kushpet/ebaz4205-sdr/hardware/Board files/README.md

# Installing Board Files

Download board files from this repository and copy ebaz4205 folder to your Xilinx Vivado installation directory "/<Vivado_version>/data/boards/board_files/".
