kushpet/ebaz4205-sdr/docs/EBAZ4205-ADC-DAC.md

| Разъём DATA1 | | | | | | | | | |
|---|---|---|-----|---|----|---|---|-----|---|
| | Верх | | | | | Низ | | | |
| | Разъем | Плата | Пин | Hw | | Разъем | Плата | Пин | Hw |
| 1 | VCC | +5V | | | 2  | VCC | +5V | | |
| 3 | Gnd | Gnd | | | 4  | Gnd | Gnd | | |
| 5 | DATA1-5  | CLK | A20 |CLK_DAC| 6  | DATA1-6  | BIT1  | H16 | DAC13 |
| 7 | DATA1-7  | BIT2  | B19 | DAC12 | 8  | DATA1-8  | BIT3  | B20 | DAC11 |
| 9 | DATA1-9  | BIT4  | C20 | DAC10 | 10 | | | | |
| 11 | DATA1-11 | BIT6  | H17 | DAC8  | 12 | gnd | | | |
| 13 | DATA1-13 | BIT8  | D20 | DAC6  | 14 | DATA1-14 | BIT5  | D18 | DAC9  |
| 15 | DATA1-15 | BIT10 | H18 | DAC4  | 16 | DATA1-16 | BIT7  | D19 | DAC7  |
| 17 | DATA1-17 | BIT12 | F20 | DAC2  | 18 | DATA1-18 | BIT9  | E19 | DAC5  |
| 19 | DATA1-19 | BIT13 | F19 | DAC1  | 20 | DATA1-20 | BIT11 | K17 | DAC3  |
| | | | | | | | | | |
| Разъём DATA2 | | | | | | | | | |
| | Верх | | | | | Низ | | | |
| | Разъем | Плата | Пин | Hw | | Разъем | Плата | Пин | Hw |
| 1 | VCC | +5V | | | 2  | VCC | +5V | | |
| 3 | Gnd | Gnd | | | 4  | Gnd | Gnd | | |
| 5 | DATA2-5  | BIT14 | G20 | DAC0  | 6  | DATA2-6  | PD | J18 | PD |
| 7 | DATA2-7  | | G19 | | 8  | DATA2-8  | | H20 | |
| 9 | DATA2-9  | | J19 | | 10 | | | | |
| 11 | DATA2-11 | | K18 | | 12 | gnd | | | |
| 13 | DATA2-13 | | K19 | | 14 | DATA2-14 | | J20 | |
| 15 | DATA2-15 | | L16 | | 16 | DATA2-16 | | L19 | |
| 17 | DATA2-17 | | M18 | | 18 | DATA2-18 | | L20 | |
| 19 | DATA2-19 | | M20 | | 20 | DATA2-20 | | L17 | |
| | | | | | | | | | |
| Разъём DATA3 | | | | | | | | | |
| | Верх | | | | | Низ | | | |
| | Разъем | Плата | Пин | Hw | | Разъем | Плата | Пин | Hw |
| 1 | VCC | +5V | | | 2  | VCC | +5V | | |
| 3 | Gnd | Gnd | | | 4  | Gnd | Gnd | | |
| 5 | DATA3-5  | CLK | M19 |CLK_ADC| 6  | DATA3-6  | BIT12 | N20 | ADC0  |
| 7 | DATA3-7  | BIT11 | P18 | ADC1  | 8  | DATA3-8  | BIT10 | M17 | ADC2  |
| 9 | DATA3-9  | BIT9  | N17 | ADC3  | 10 | | | | |
| 11 | DATA3-11 | BIT7  | P20 | ADC5  | 12 | gnd | | | |
| 13 | DATA3-13 | BIT5  | R18 | ADC7  | 14 | DATA3-14 | BIT8  | R19 | ADC4  |
| 15 | DATA3-15 | BIT3  | P19 | ADC9  | 16 | DATA3-16 | BIT6  | T20 | ADC6  |
| 17 | DATA3-17 | BIT1  | U20 | ADC11 | 18 | DATA3-18 | BIT4  | T19 | ADC8  |
| 19 | DATA3-19 | OTR | V20 | OTR | 20 | DATA3-20 | BIT2  | U19 | ADC10 |
