kushpet/ebaz4205-sdr/docs/ebaz4205_schematic_color.pdf

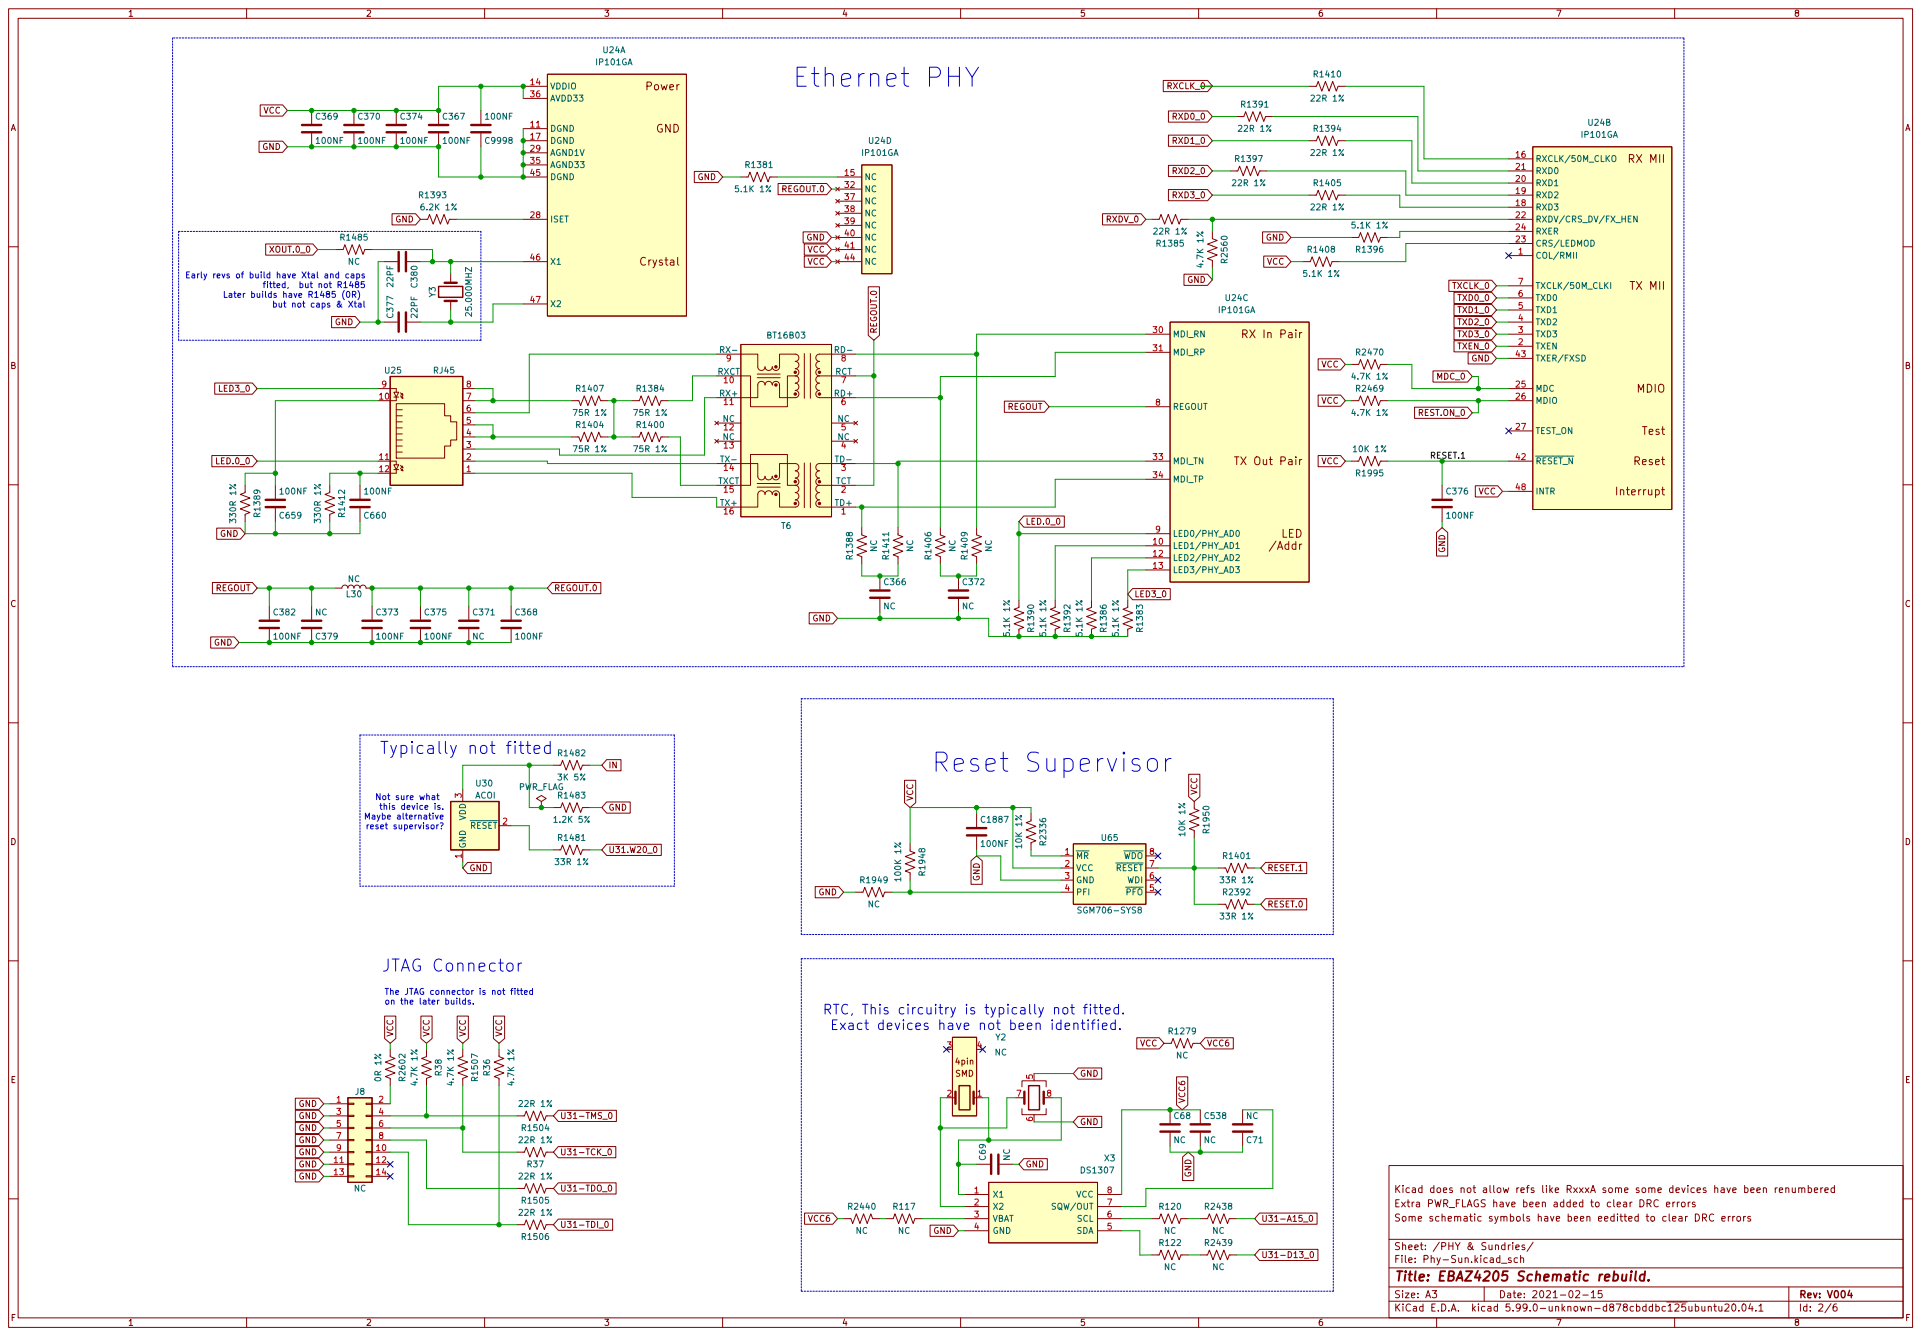
[picture p2: page 1]

RESET.1 Early revs of build have Xtal and caps

but not caps & Xtal

JTAG Connector Not sure what
this device is. Maybe alternative

reset supervisor? The JTAG connector is not fitted

RTC, This circuitry is typically not fitted.
Exact devices have not been identified.

File: Phy-Sun.kicad_sch Sheet: /PHY & Sundries/ Some schematic symbols have been eeditted to clear DRC errors

Id: 2/6 Title: EBAZ4205 Schematic rebuild.

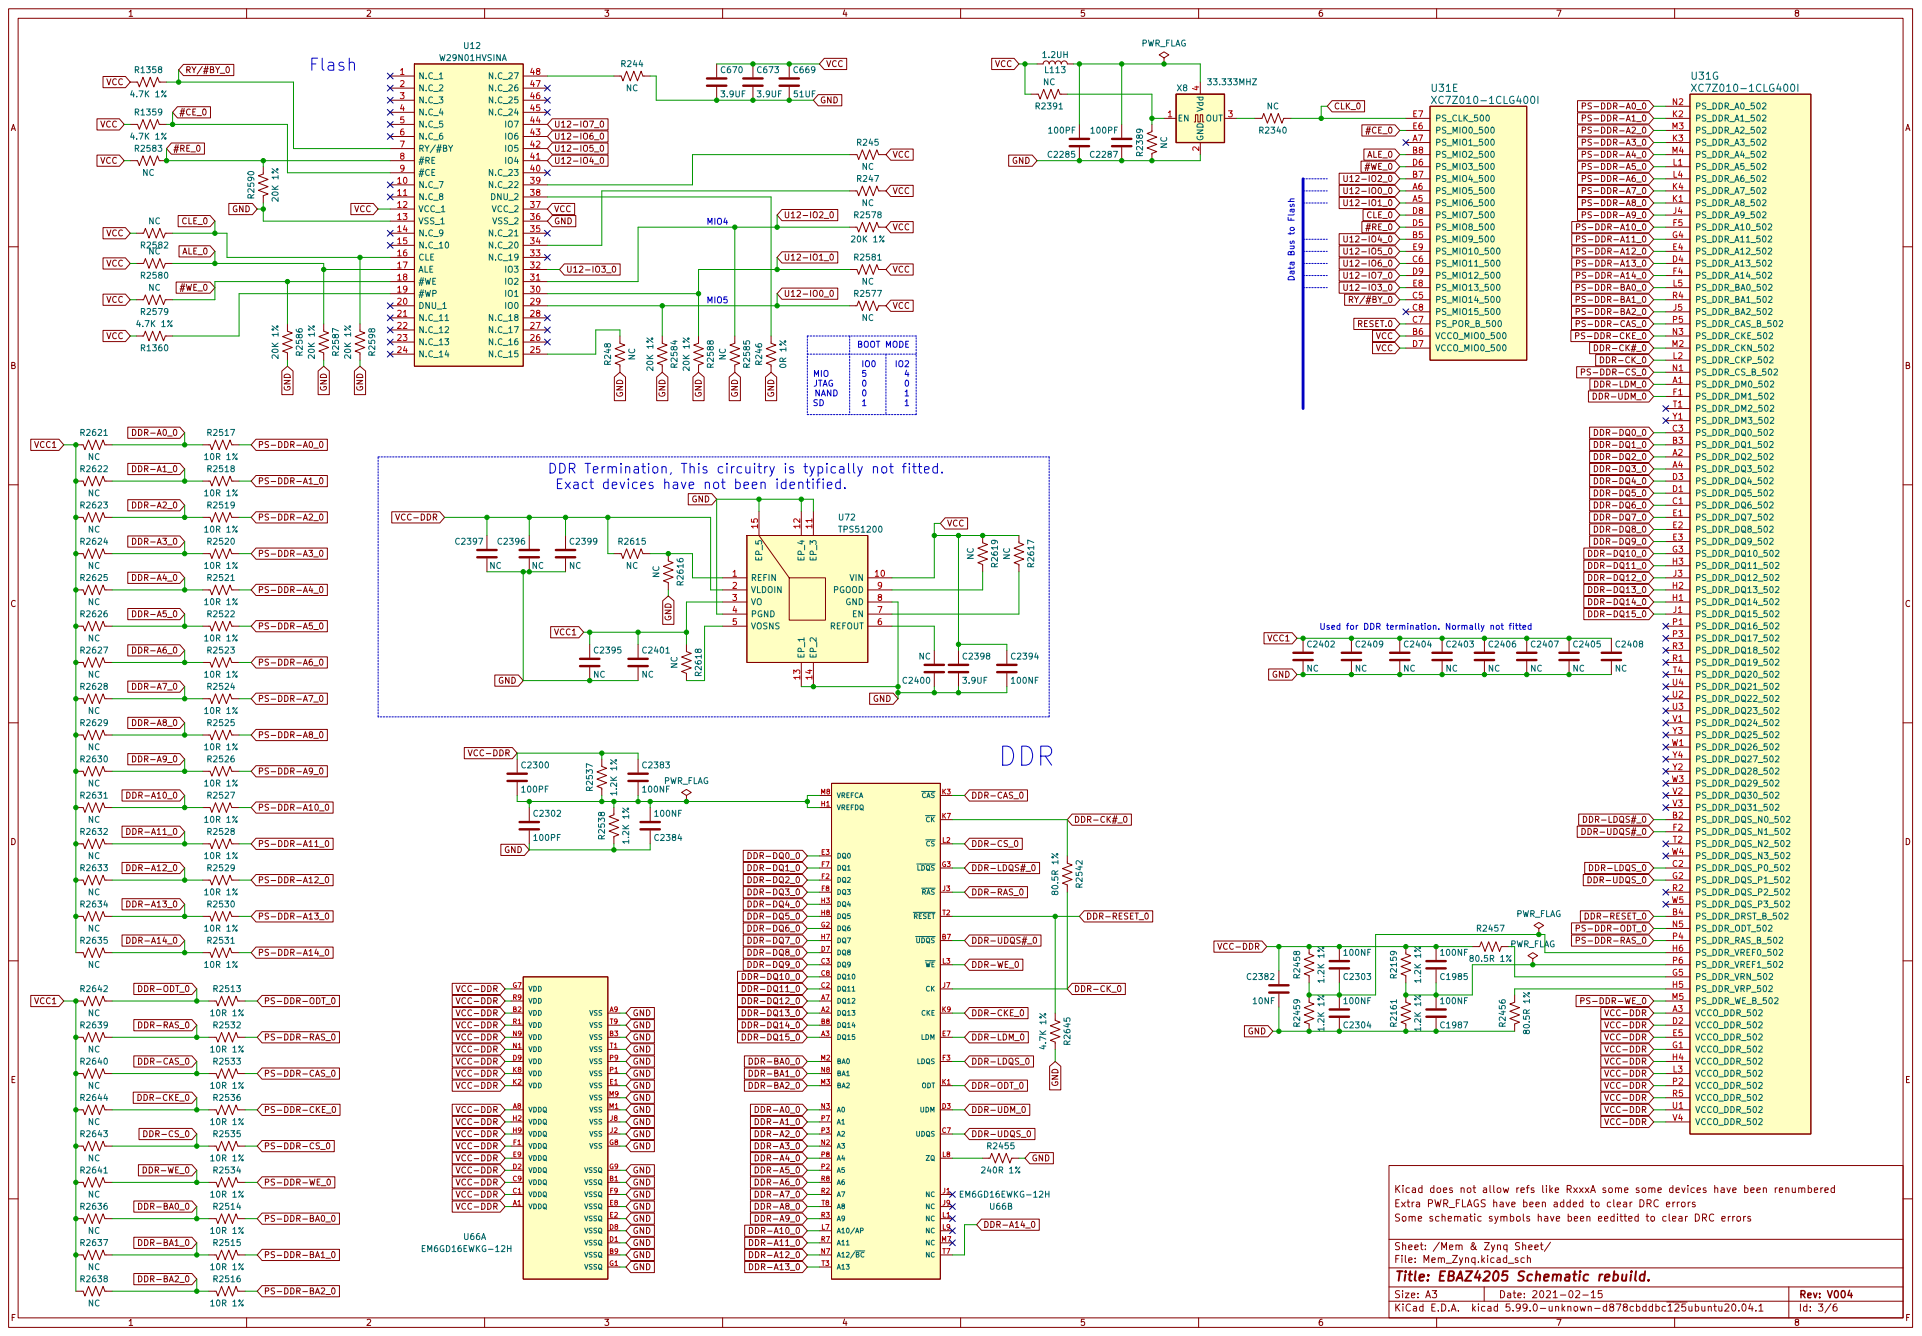
[picture p3: page 2]

XC7Z010-1CLG400I R2522
PS-DDR-A13_0 PS-DDR-A14_0 PS-DDR-BA0_0 PS-DDR-BA1_0 PS-DDR-A7_0 VCC

PS-DDR-A2_0 PS-DDR-A12_0 PS-DDR-A4_0 U12-IO1_0 U12-IO0_0 U12-IO2_0

MIO5 DDR Termination, This circuitry is typically not fitted.

PS-DDR-BA2_0 PS-DDR-CAS_0 PS-DDR-CKE_0 DDR-CK#_0 DDR-CK_0 PS-DDR-CS_0 DDR-LDM_0 DDR-UDM_0
DDR-DQ8_0 DDR-DQ9_0 DDR-LDQS#_0 DDR-UDQS#_0 DDR-LDQS_0 DDR-UDQS_0 DDR-RESET_0 PS-DDR-ODT_0 PS-DDR-RAS_0 PS-DDR-WE_0

DDR-DQ7_0 DDR-DQ3_0 DDR-DQ6_0 DDR-DQ5_0 DDR-DQ4_0

Exact devices have not been identified.

VCC1 GND
DDR-RESET_0 DDR-CK#_0 GND

VCC-DDR
DDR-BA0_0 DDR-A12_0 DDR-A11_0 DDR-A10_0 DDR-A9_0 DDR-A8_0 DDR-A7_0 DDR-A6_0 DDR-A5_0 DDR-A4_0 DDR-A3_0 DDR-A2_0 DDR-A1_0 DDR-A0_0 DDR-BA2_0 DDR-BA1_0 VCC-DDR

VCC-DDR GND GND GND GND

Extra PWR_FLAGS have been added to clear DRC errors Kicad does not allow refs like RxxxA some some devices have been renumbered R2515

Some schematic symbols have been eeditted to clear DRC errors

Sheet: /Mem & Zynq Sheet/
File: Mem_Zynq.kicad_sch
Id: 3/6 Title: EBAZ4205 Schematic rebuild.

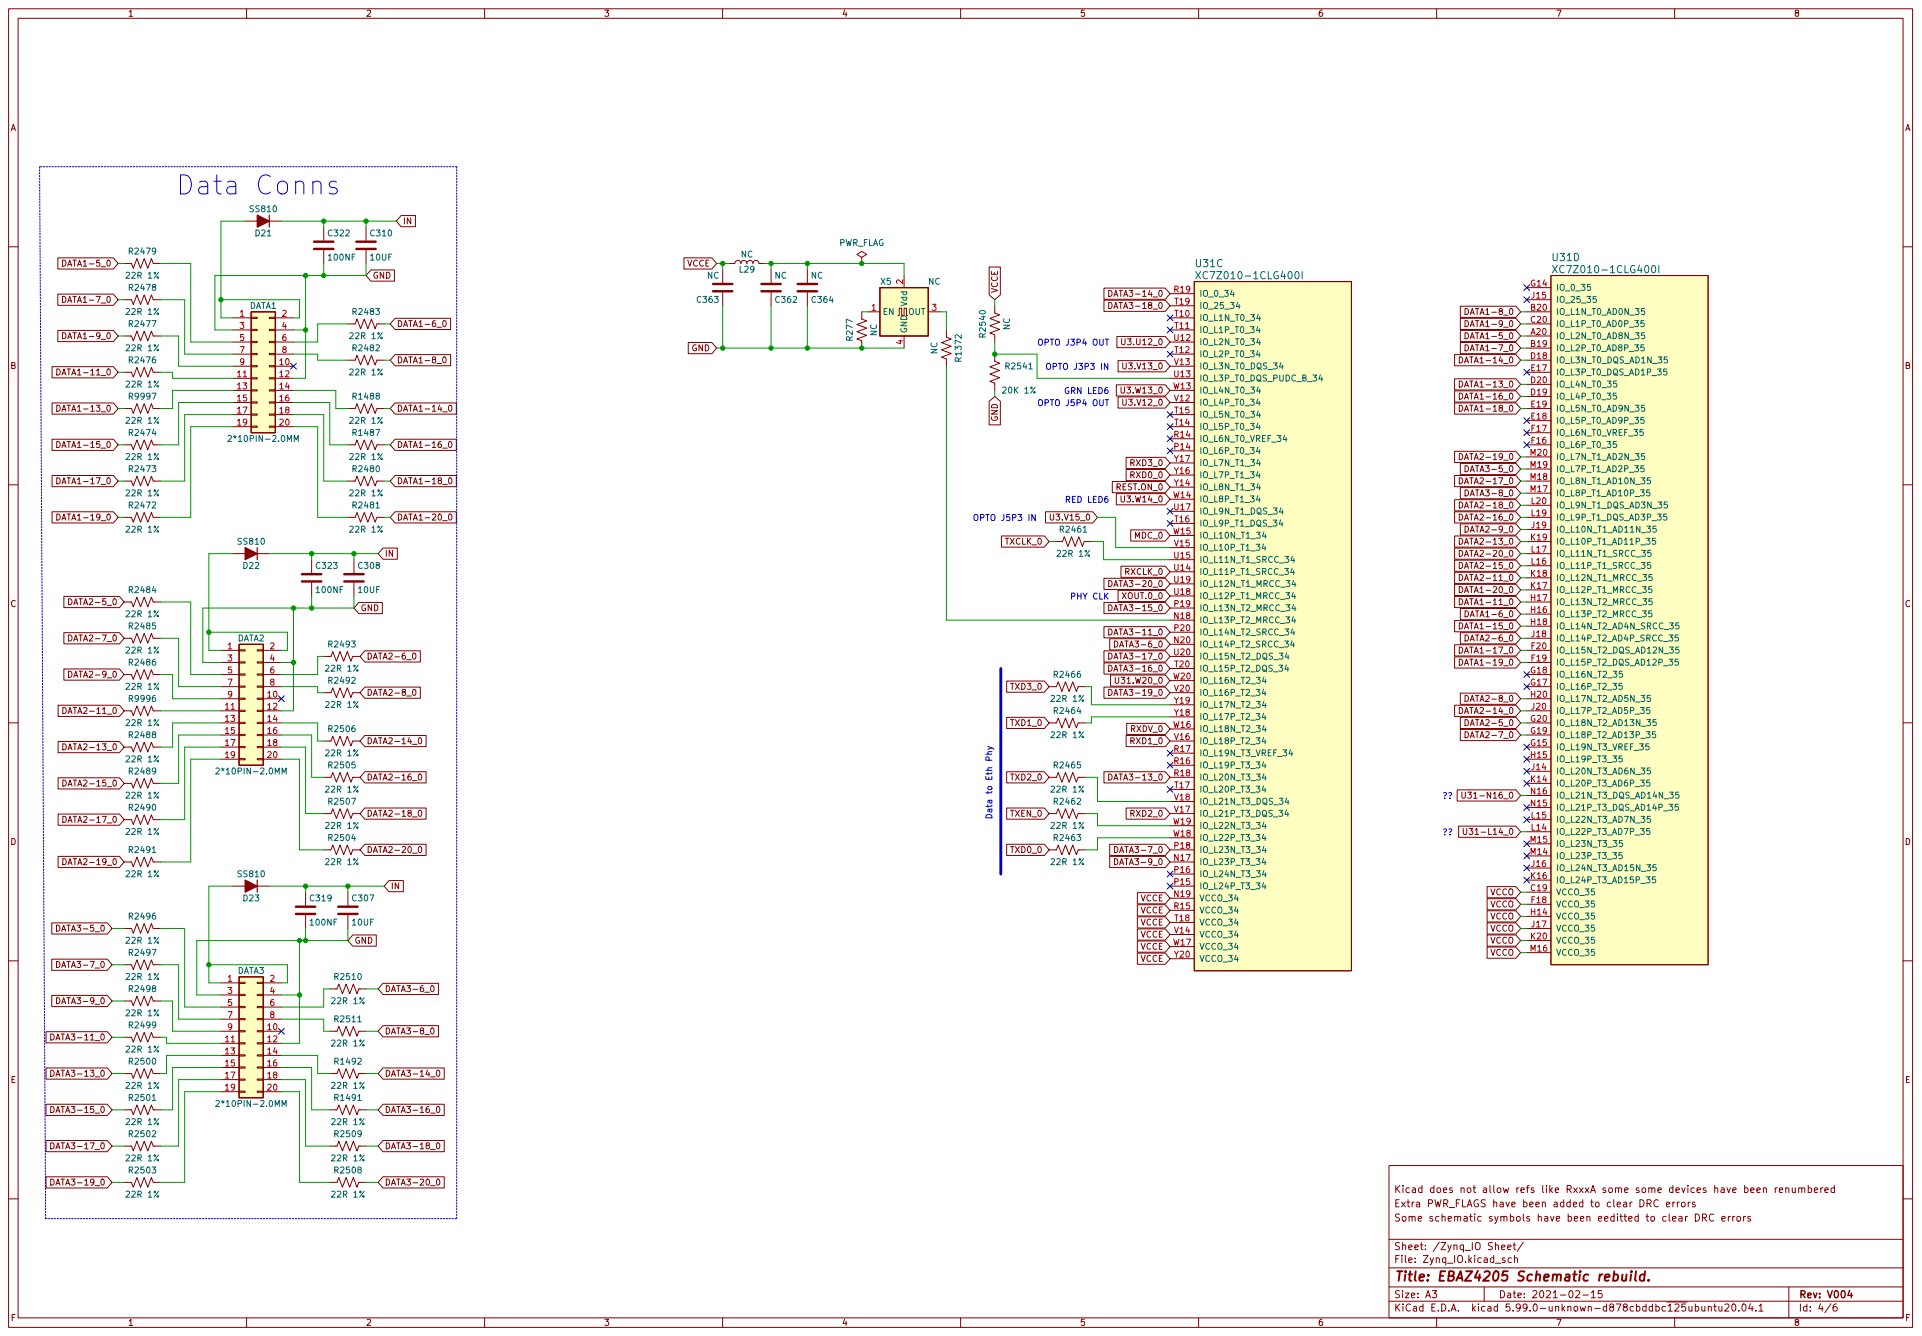
[picture p4: page 3]
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

Some schematic symbols have been eeditted to clear DRC errors

Sheet: /Zynq_IO Sheet/
File: Zynq_IO.kicad_sch
Id: 4/6 Title: EBAZ4205 Schematic rebuild.

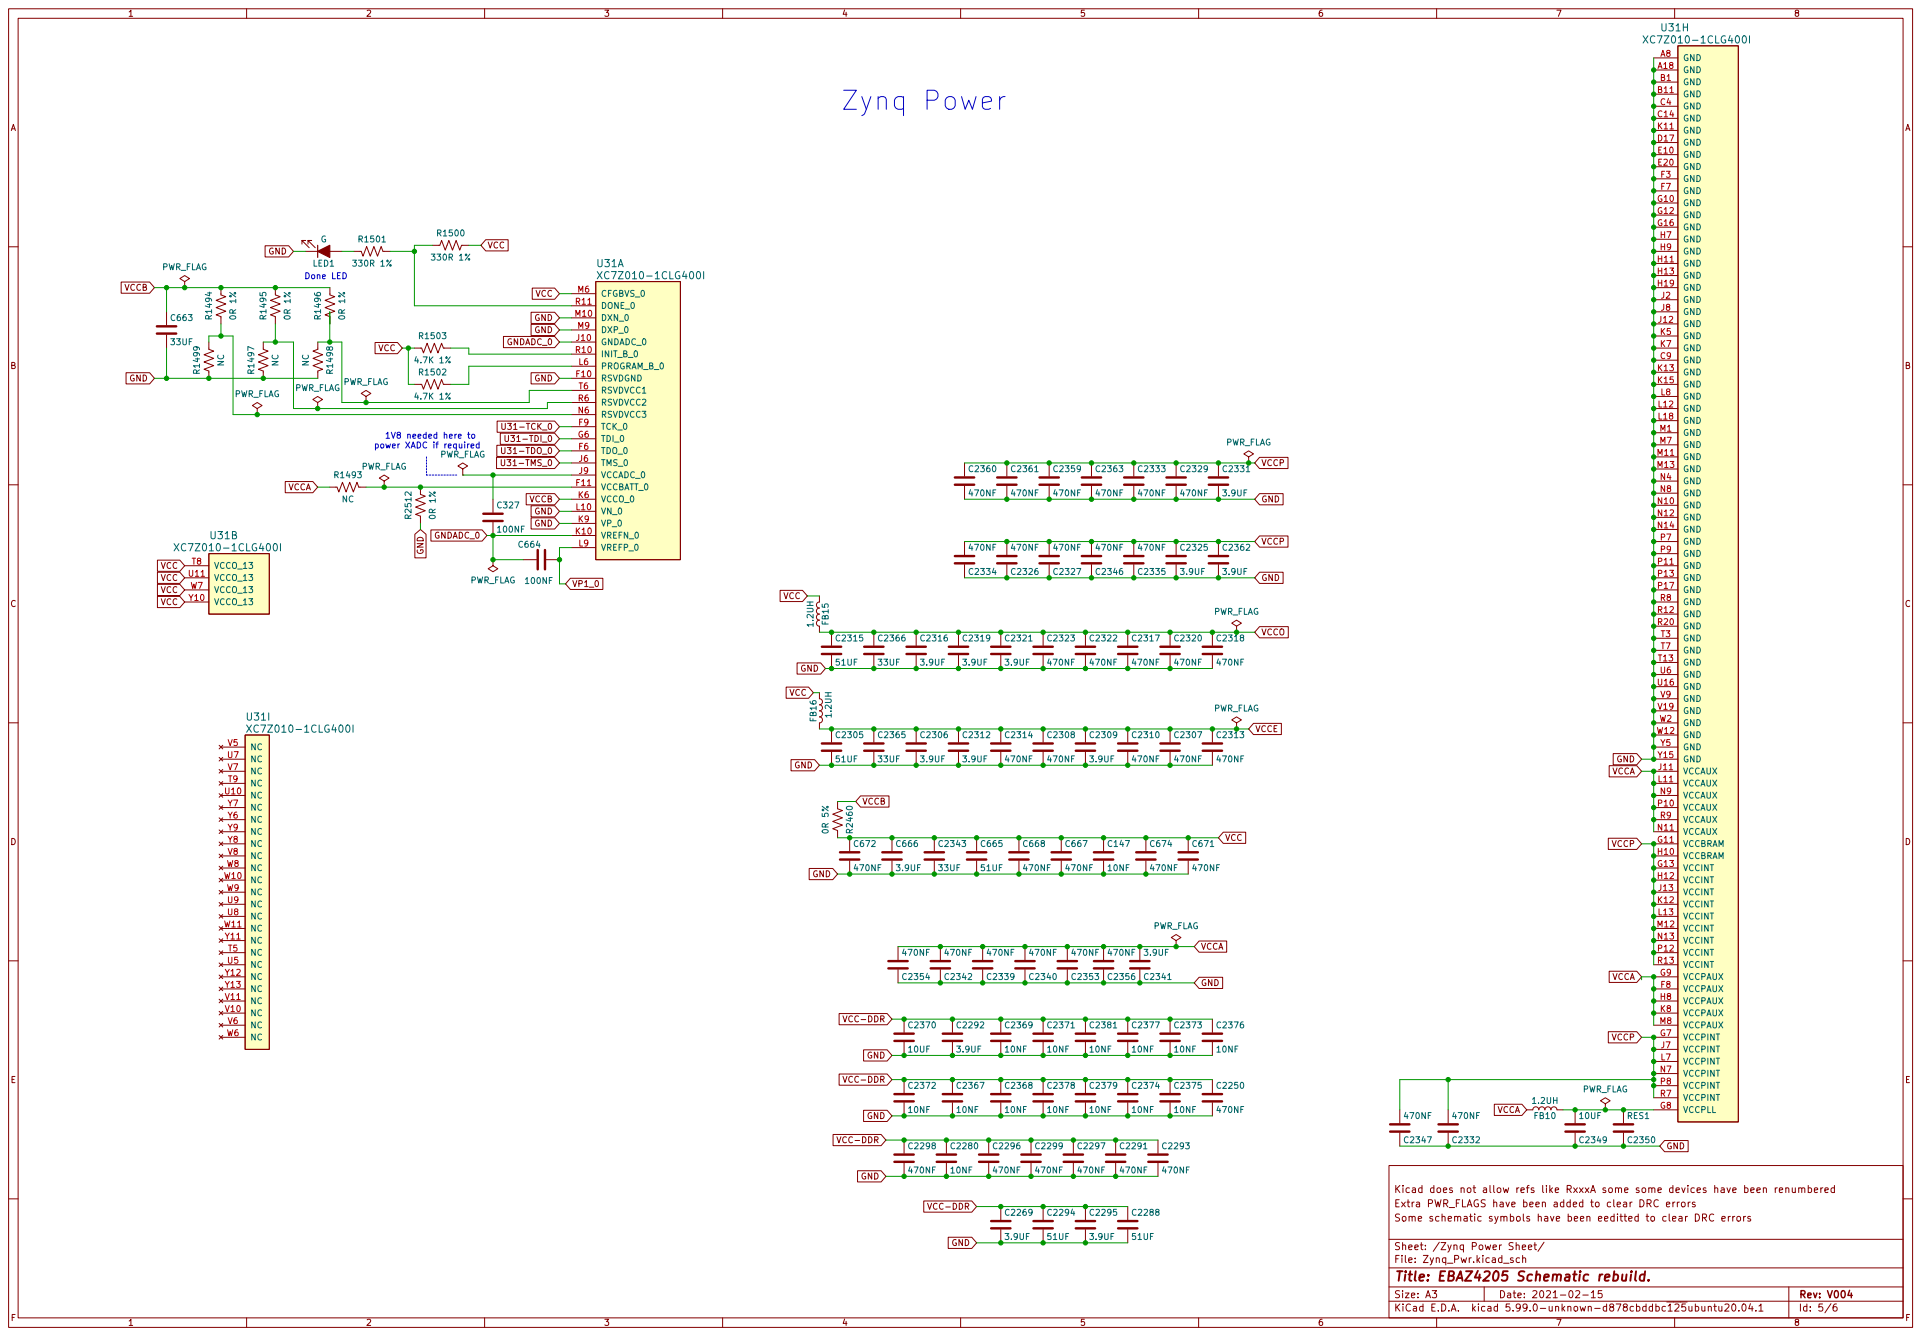
[picture p5: page 4]

1V8 needed here to power XADC if required

Extra PWR_FLAGS have been added to clear DRC errors Kicad does not allow refs like RxxxA some some devices have been renumbered C2373

Some schematic symbols have been eeditted to clear DRC errors

Sheet: /Zynq Power Sheet/
File: Zynq_Pwr.kicad_sch
Id: 5/6 Title: EBAZ4205 Schematic rebuild.

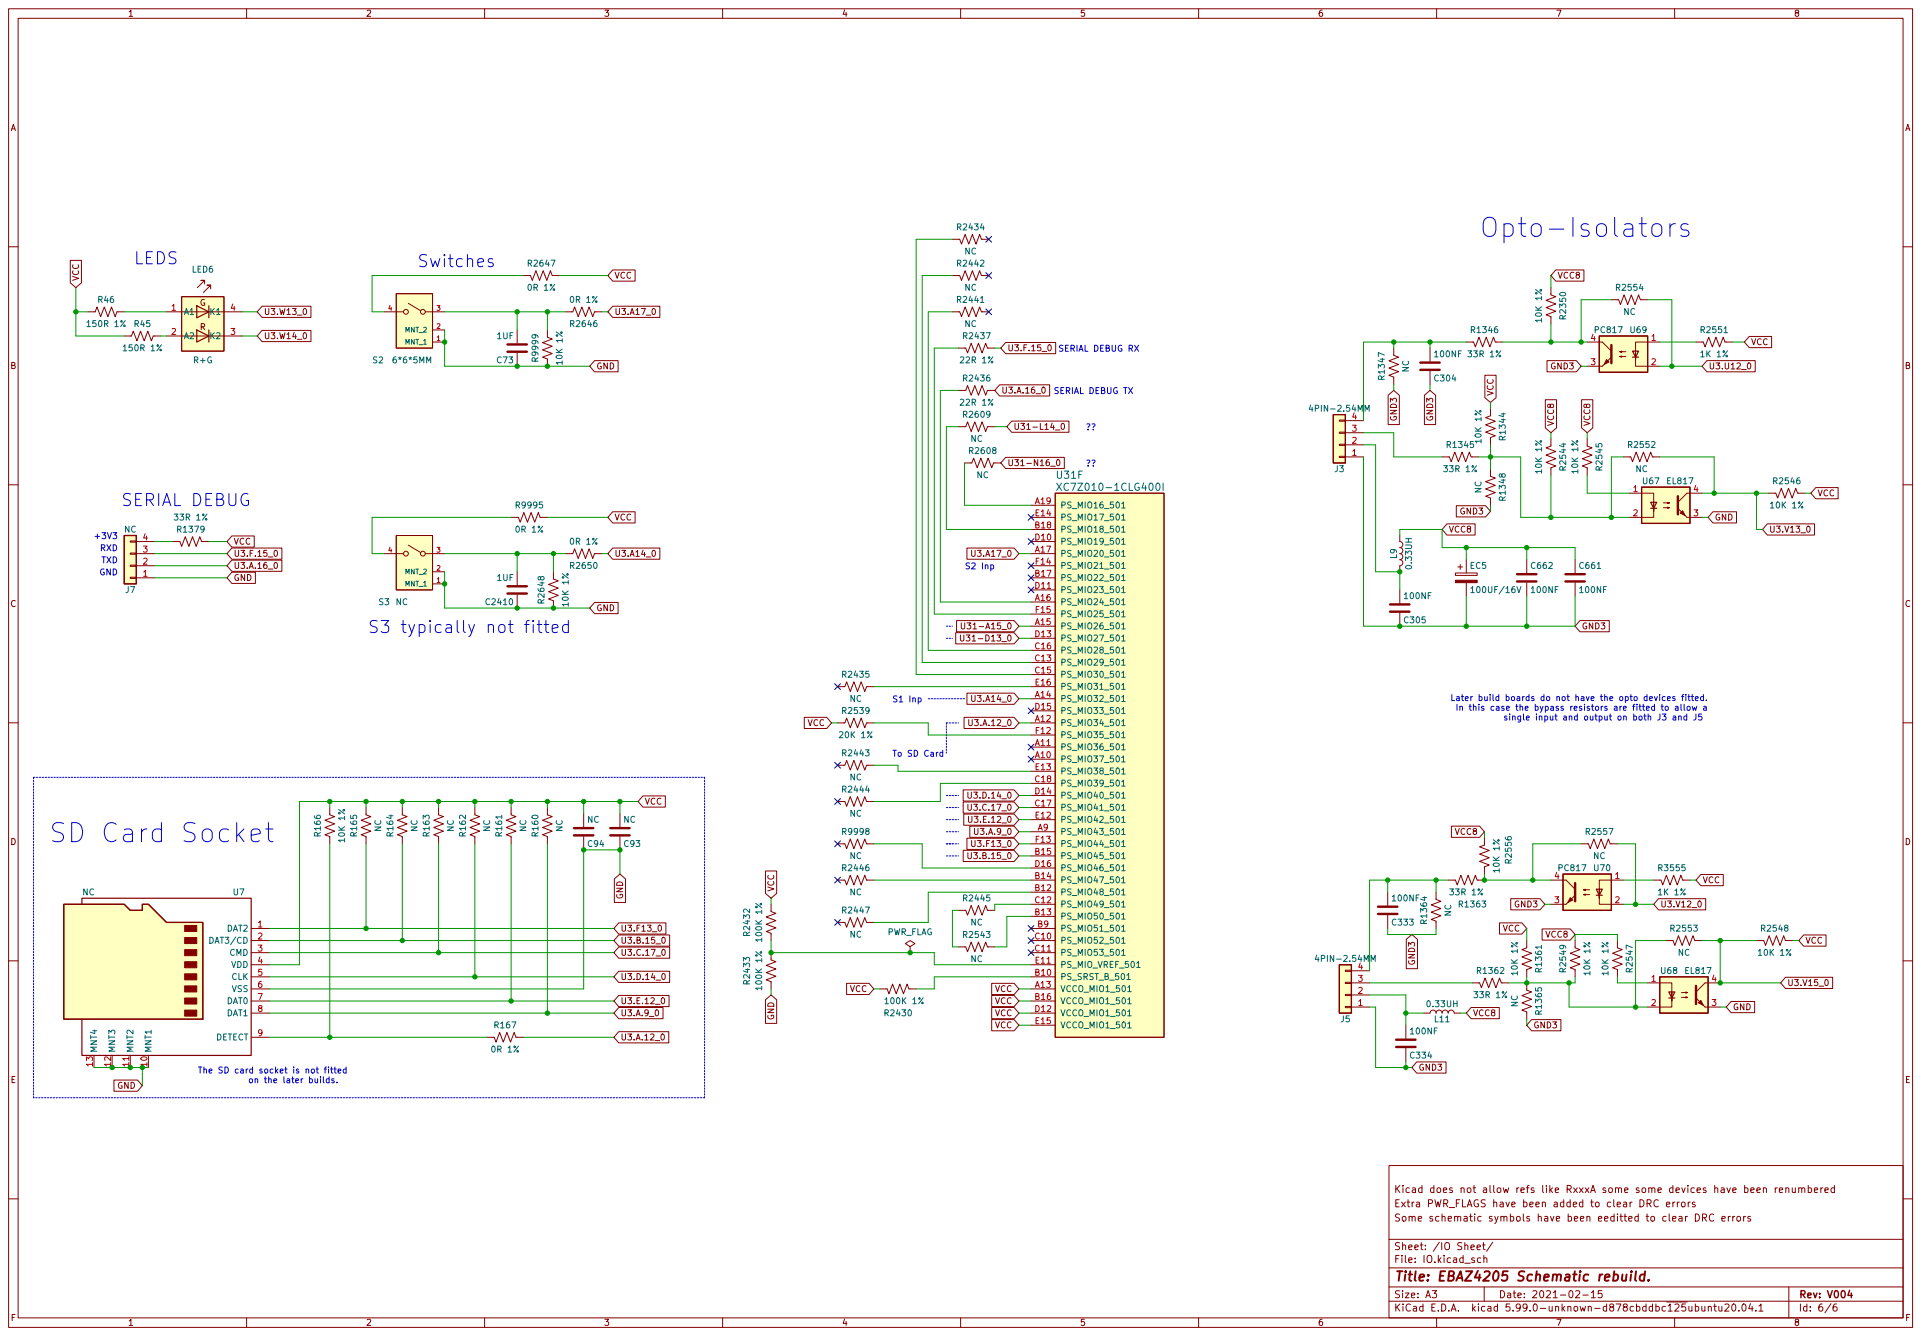
[picture p6: page 5]

single input and output on both J3 and J5 ?? SERIAL DEBUG RX

S2 Inp To SD Card

Later build boards do not have the opto devices fitted.
In this case the bypass resistors are fitted to allow a

on the later builds.

File: IO.kicad_sch Sheet: /IO Sheet/ Some schematic symbols have been eeditted to clear DRC errors

Id: 6/6 Title: EBAZ4205 Schematic rebuild.

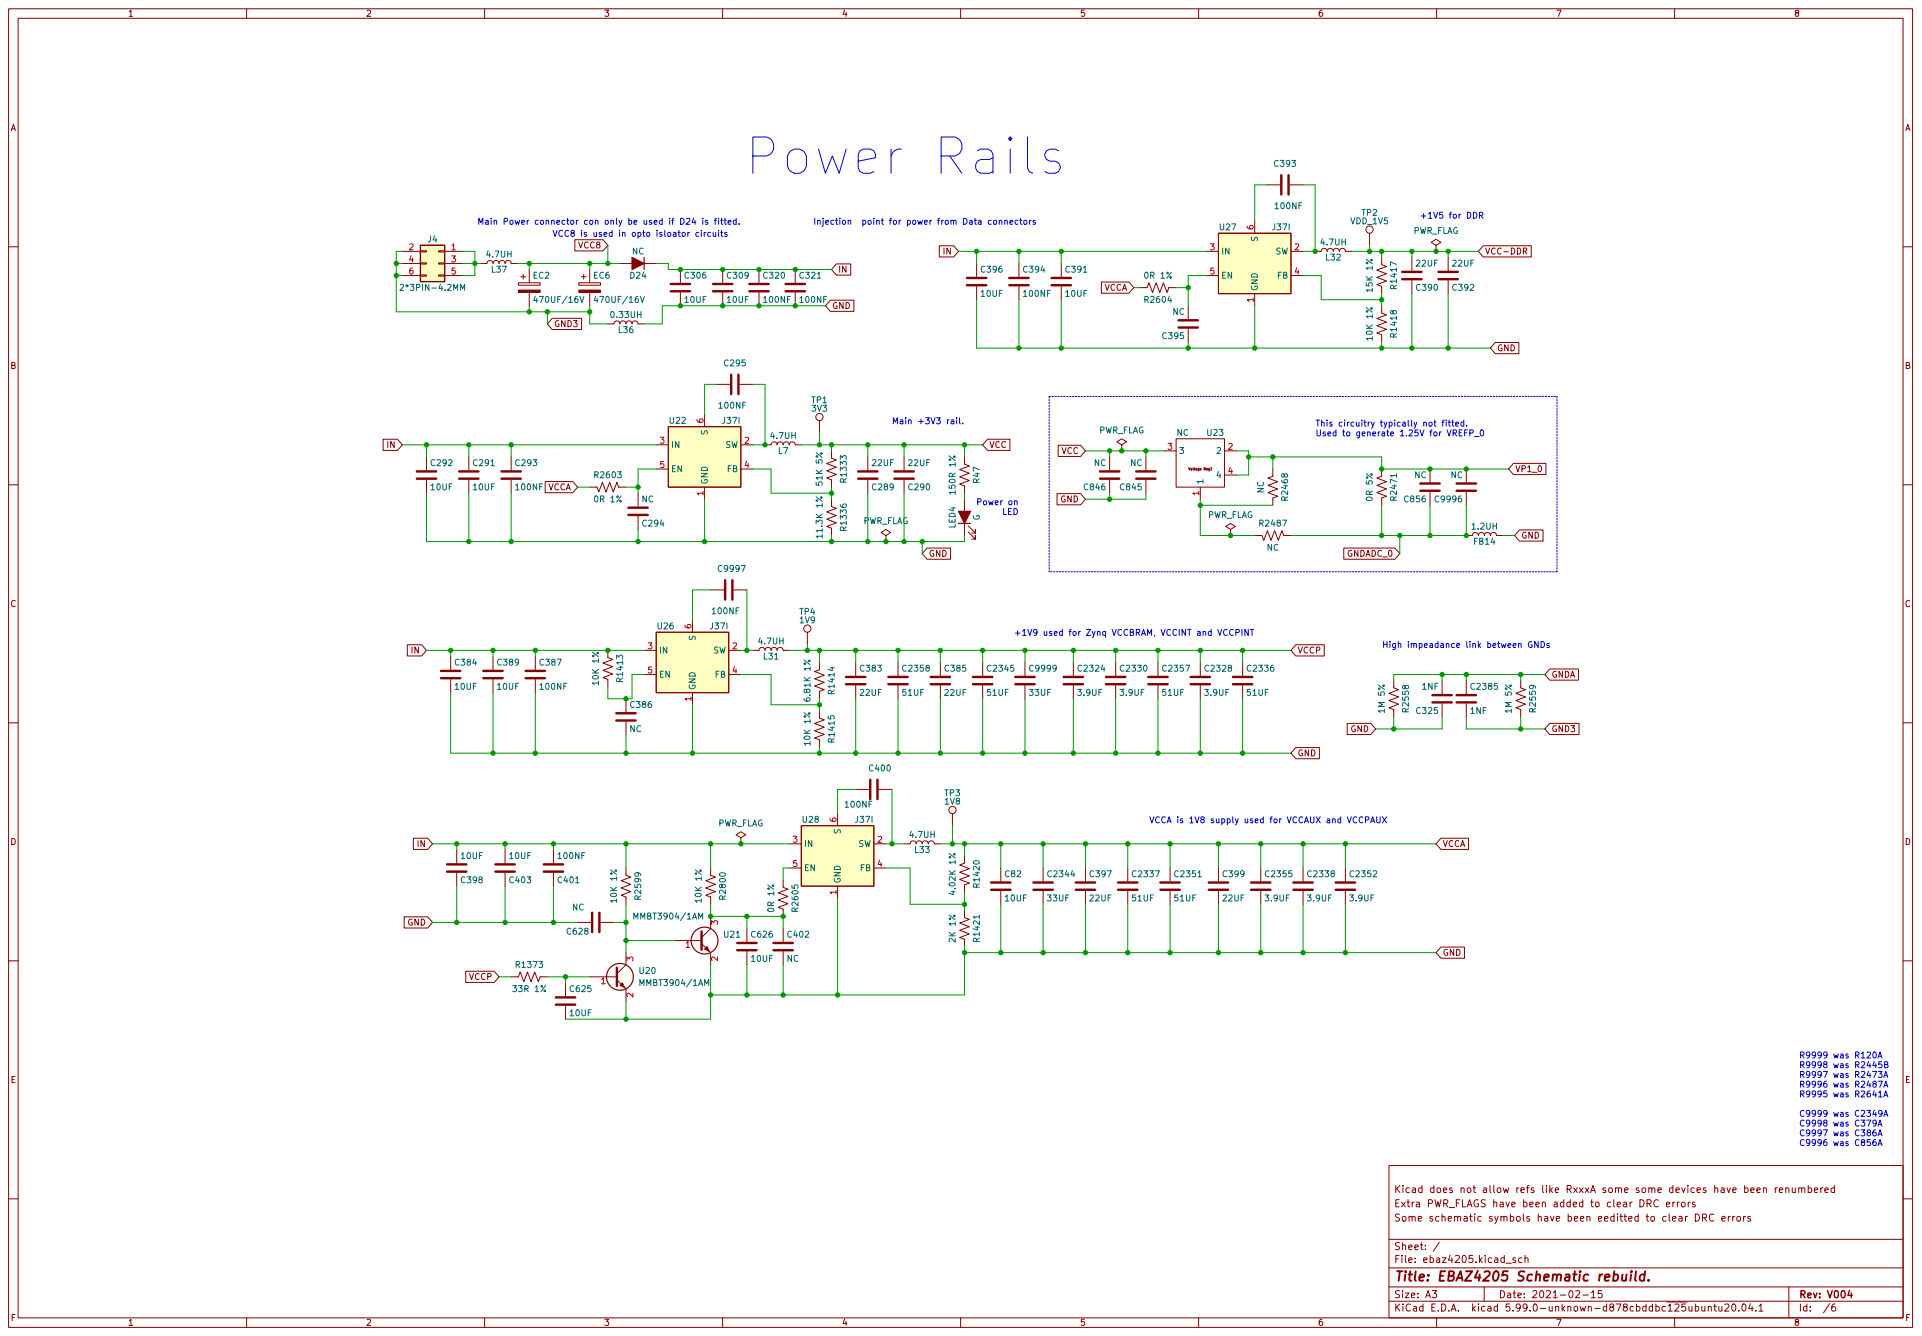
[picture p7: page 6]

Injection point for power from Data connectors

This circuitry typically not fitted.
Used to generate 1.25V for VREFP_0

High impeadance link between GNDs

VCCA is 1V8 supply used for VCCAUX and VCCPAUX

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

File: ebaz4205.kicad_sch Sheet: / Some schematic symbols have been eeditted to clear DRC errors

Id: /6 Title: EBAZ4205 Schematic rebuild.
