kushpet/ebaz4205-sdr/docs/AD9226-V1.2-board.pdf

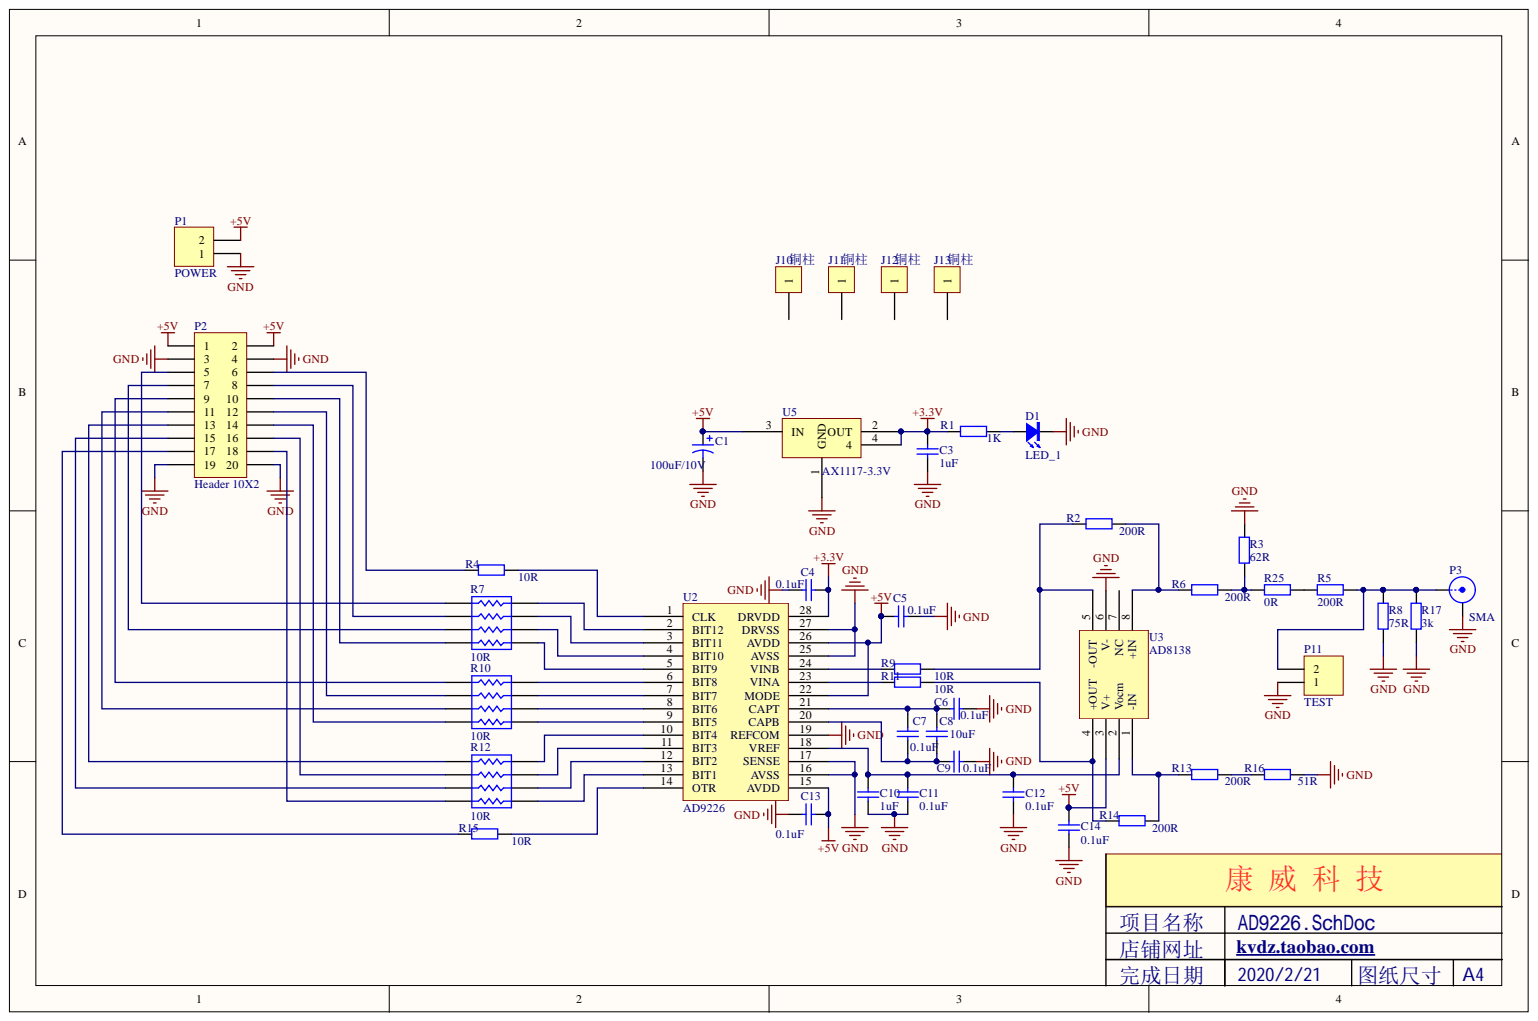
[picture p8: page 1]

P2Header 1 7 8

9 1 0
1 1 1 2
1 3 1 4
1 5 1 6
1 7 1 8

-IN 1 Vocm 2 V+ 3 +OUT 4 -OUT 5 V- 6 NC 7 +IN 8

1 1 | | | F
1 2
1 3 | 1 | C9 | 0.1 u F
1 4 | 1 5 | C1 | | V
