kushpet/ebaz4205-sdr/docs/DAC904-board.pdf

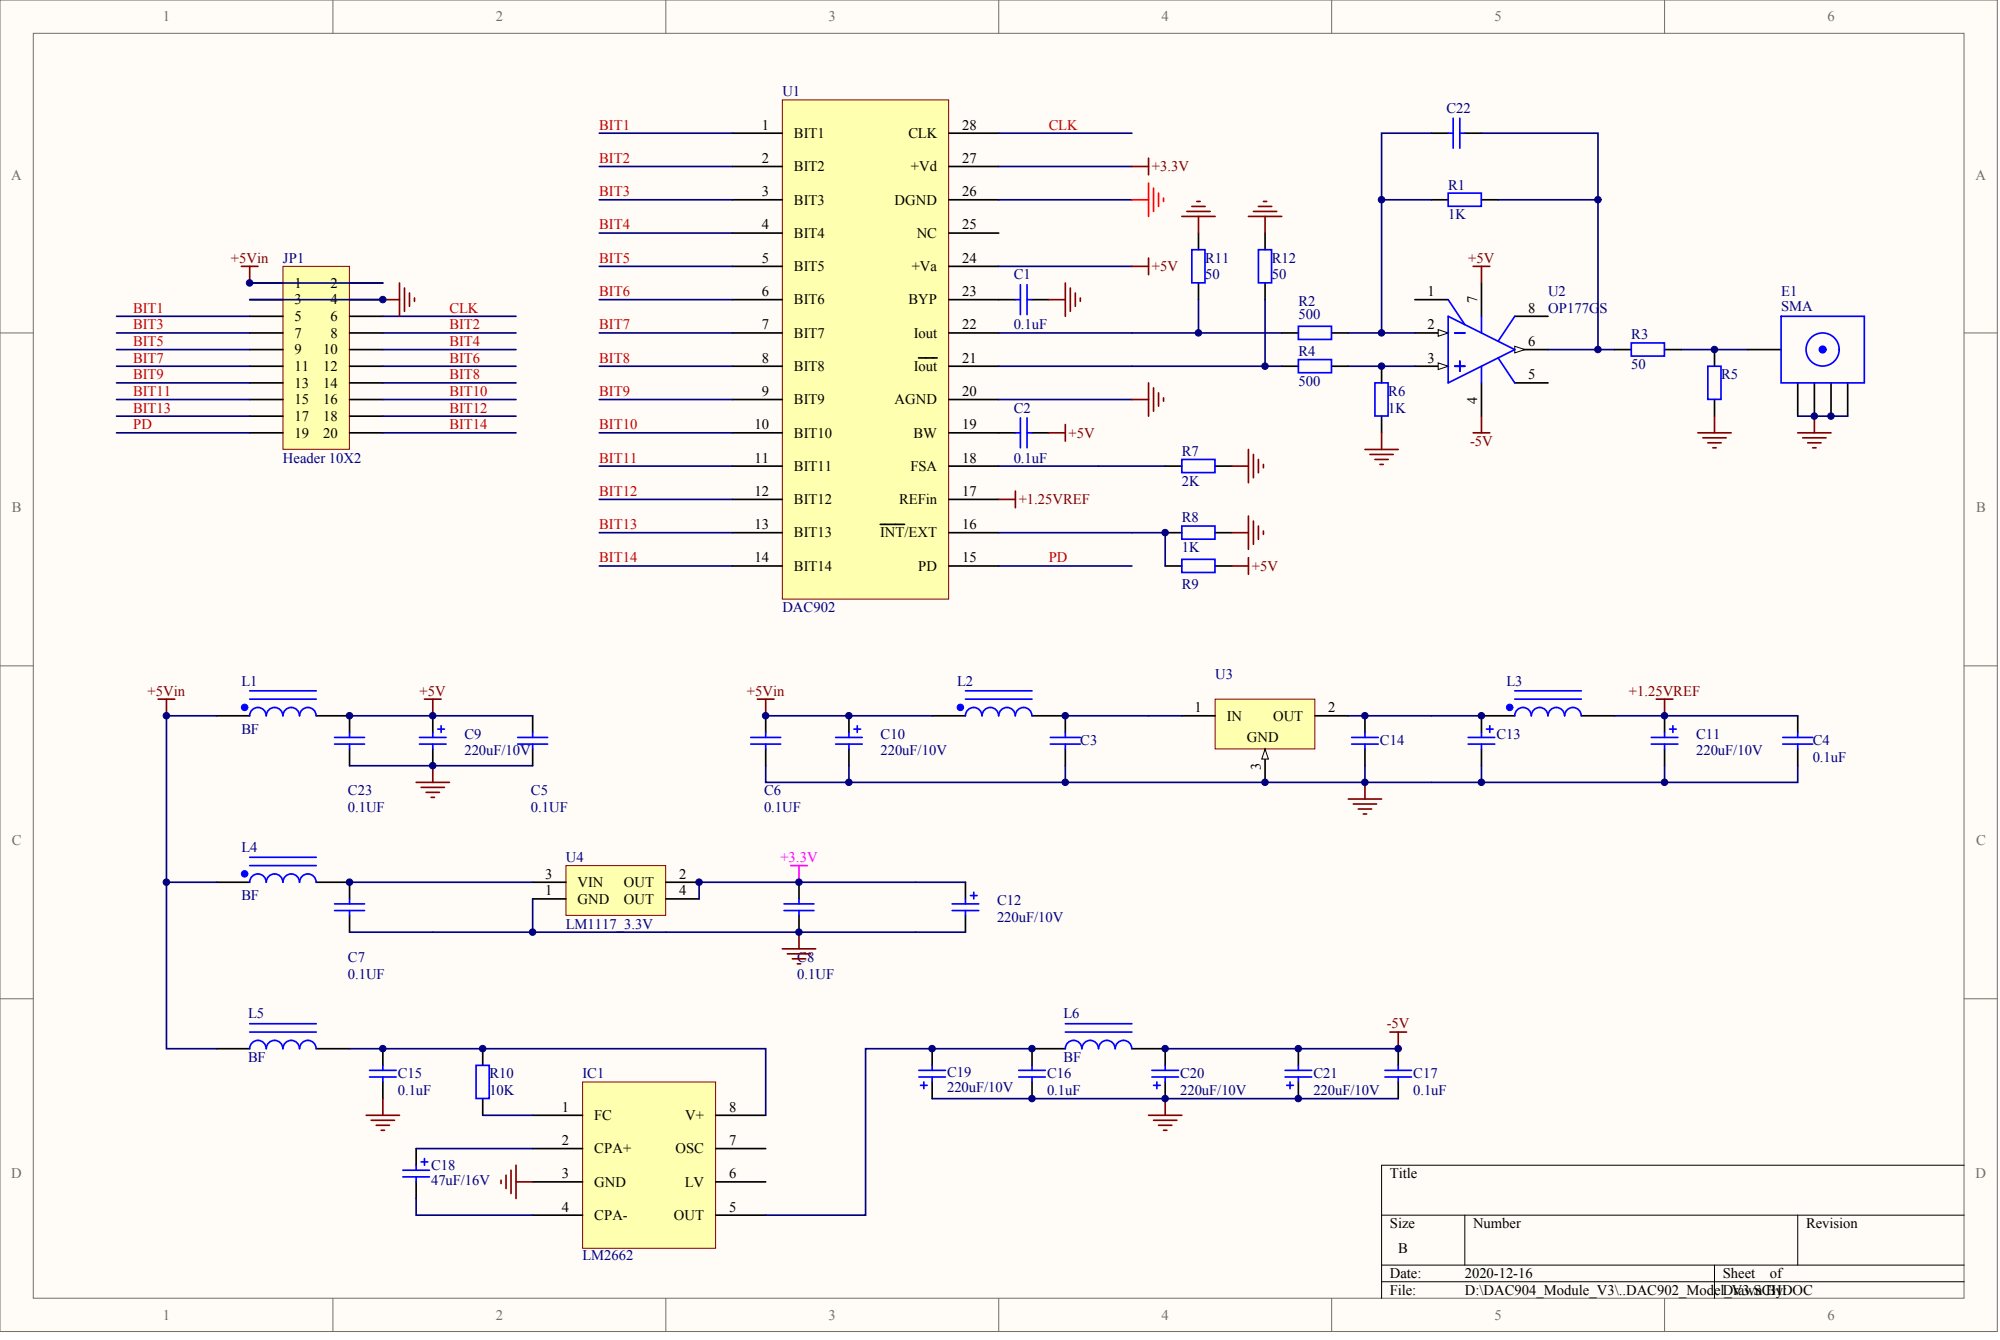
[picture p9: page 1]

CPA+ 2 OSC P0IC107 P0IC107 P0IC107 LV | 7

GND 3 | 6 P0IC106 P0IC106 P0IC106
