kushpet/ebaz4205-sdr/hardware/rtl/hb_fir_decimator.v

// hardware/rtl/hb_fir_decimator.v
// Halfband FIR decimator x2, 63-tap (32 non-zero), transposed form
// CIC-compensating coefficients (R_max=120, N=5, Parks-McClellan)
// Input: 16-bit signed @ fs_cic  Output: 16-bit signed @ fs_cic/2
// Single channel — instantiate for I and Q separately
// DSP48: 16 (symmetric pairs, center = >>1 shift, no DSP)
//
// Coefficient set (h[0],h[2],...,h[30]): 18-bit Q16
//   h[31]=65536 (center, 0.5 in Q16, done as arithmetic right shift)
//   h[i] = h[62-i] (linear phase symmetry)

module hb_fir_decimator #(
    parameter B_IN  = 16,
    parameter B_OUT = 16,
    parameter B_ACC = 42,   // B_IN+1 + 18 + log2(16) = 39 -> 42 safe
    parameter AXI_ADDR_WIDTH = 6
)(
    input  wire               clk,
    input  wire               resetn,
    input  wire [B_IN-1:0]    din,
    input  wire               din_valid,
    output reg  [B_OUT-1:0]   dout,
    output reg                dout_valid,
    // AXI-Lite: optional coefficient reload (offsets 0x00..0x3C = 16 regs)
    input  wire [AXI_ADDR_WIDTH-1:0] s_axil_awaddr,
    input  wire               s_axil_awvalid,
    output reg                s_axil_awready,
    input  wire [31:0]        s_axil_wdata,
    input  wire               s_axil_wvalid,
    output reg                s_axil_wready,
    output reg  [1:0]         s_axil_bresp,
    output reg                s_axil_bvalid,
    input  wire               s_axil_bready,
    input  wire [AXI_ADDR_WIDTH-1:0] s_axil_araddr,
    input  wire               s_axil_arvalid,
    output reg                s_axil_arready,
    output reg  [31:0]        s_axil_rdata,
    output reg  [1:0]         s_axil_rresp,
    output reg                s_axil_rvalid,
    input  wire               s_axil_rready
);

// ---- Coefficients ROM (16 values, h[0],h[2],...,h[30]) ----
// Stored as 18-bit signed Q16 (1 sign + 1 integer + 16 frac)
// CIC-compensating for R_max=120, Parks-McClellan
reg signed [17:0] coef [0:15];
integer ci;
initial begin
    coef[ 0] = 18'sh3FFB2; // h[ 0] =    -78  (sign-extended 18-bit)
    coef[ 1] = 18'sh000C2; // h[ 2] =    194
    coef[ 2] = 18'sh3FF17; // h[ 4] =   -233
    coef[ 3] = 18'sh0016A; // h[ 6] =    362
    coef[ 4] = 18'sh3FDFE; // h[ 8] =   -514
    coef[ 5] = 18'sh002C9; // h[10] =    713
    coef[ 6] = 18'sh3FC3E; // h[12] =   -966
    coef[ 7] = 18'sh00507; // h[14] =   1287
    coef[ 8] = 18'sh3F961; // h[16] =  -1695
    coef[ 9] = 18'sh008AF; // h[18] =   2223
    coef[10] = 18'sh3F4DC; // h[20] =  -2924
    coef[11] = 18'sh00F3C; // h[22] =   3900
    coef[12] = 18'sh3EAD4; // h[24] =  -5372
    coef[13] = 18'sh01EEC; // h[26] =   7916
    coef[14] = 18'sh3CA71; // h[28] = -13647
    coef[15] = 18'sh0A2A2; // h[30] =  41634
end

// ---- AXI-Lite: coefficient reload ----
always @(posedge clk) begin
    if (!resetn) begin
        s_axil_awready <= 1'b0; s_axil_wready <= 1'b0;
        s_axil_bvalid  <= 1'b0; s_axil_bresp  <= 2'b00;
    end else begin
        s_axil_awready <= s_axil_awvalid & s_axil_wvalid & ~s_axil_awready;
        s_axil_wready  <= s_axil_awvalid & s_axil_wvalid & ~s_axil_wready;
        if (s_axil_awvalid && s_axil_wvalid && s_axil_awready && s_axil_wready) begin
            coef[s_axil_awaddr[5:2]] <= s_axil_wdata[17:0];
            s_axil_bvalid <= 1'b1; s_axil_bresp <= 2'b00;
        end else if (s_axil_bready)
            s_axil_bvalid <= 1'b0;
    end
end
always @(posedge clk) begin
    if (!resetn) begin
        s_axil_arready <= 1'b0; s_axil_rvalid <= 1'b0;
        s_axil_rdata   <= 32'd0; s_axil_rresp  <= 2'b00;
    end else begin
        if (s_axil_arvalid && ~s_axil_arready) begin
            s_axil_arready <= 1'b1;
            s_axil_rdata   <= {14'd0, coef[s_axil_araddr[5:2]]};
            s_axil_rresp   <= 2'b00; s_axil_rvalid <= 1'b1;
        end else
            s_axil_arready <= 1'b0;
        if (s_axil_rvalid && s_axil_rready)
            s_axil_rvalid <= 1'b0;
    end
end

// ---- Sample shift register: 63 taps ----
reg signed [B_IN-1:0] sr [0:62];
integer i;
always @(posedge clk) begin
    if (!resetn) begin
        for (i = 0; i < 63; i = i + 1) sr[i] <= {B_IN{1'b0}};
    end else if (din_valid) begin
        sr[0] <= din;
        for (i = 1; i < 63; i = i + 1) sr[i] <= sr[i-1];
    end
end

// ---- Decimation counter: output every 2nd input sample ----
reg phase;
always @(posedge clk) begin
    if (!resetn)       phase <= 1'b0;
    else if (din_valid) phase <= ~phase;
end

// ---- Transposed-form symmetric FIR ----
// On even phase (phase==0 after input):
// Pre-add: sym_add[k] = sr[2k] + sr[62-2k]  (k=0..15)
// Multiply: sym_add[k] * coef[k]
// Center:   sr[31] >> 1  (h[31]=0.5 exactly)
// Sum all -> accumulator

wire signed [B_IN:0] sym_add [0:15];
genvar k;
generate
    for (k = 0; k < 16; k = k + 1) begin : GEN_SYM
        assign sym_add[k] = {{1{sr[2*k][B_IN-1]}}, sr[2*k]} +
                            {{1{sr[62-2*k][B_IN-1]}}, sr[62-2*k]};
    end
endgenerate

// Pipeline stage 1: multiply sym_add[k] * coef[k]
reg signed [B_IN+18:0] prod [0:15];  // (B_IN+1) + 18 = 35 bits
reg                    pipe1_valid;
always @(posedge clk) begin
    if (!resetn) begin
        pipe1_valid <= 1'b0;
        for (i = 0; i < 16; i = i + 1) prod[i] <= {(B_IN+19){1'b0}};
    end else begin
        pipe1_valid <= din_valid && (phase == 1'b0);
        if (din_valid && (phase == 1'b0))
            for (i = 0; i < 16; i = i + 1)
                prod[i] <= sym_add[i] * coef[i];
    end
end

// Pipeline stage 2: tree sum of 16 products + center term.
//
// Split across two clock cycles (2a: 4 partial sums; 2b: combine with
// center). The original single-cycle 16-way sum inferred a ~14-DSP-deep
// adder chain that drove WNS = -12.6 ns at 60 MHz on the routed design
// — the PS/AXI clock then never came up cleanly and the firmware never
// printed a UART banner. Splitting gives each stage ≤ 4 adds in series.
//
// Two Verilog signedness traps live in this stage:
//
//   1. {x, y} concatenations are *unsigned* regardless of the
//      operand types. When mixed with signed prod[k] in a `+`, the
//      whole expression goes unsigned and each negative prod (35-bit
//      signed bit pattern with bit 34 = 1) is reinterpreted as a
//      large positive ~2^35 number. Sum-of-eight-negatives then
//      lands near 2^38, sails through saturation, and the FIR pins
//      to ±32767 on quiet input.
//
//   2. {tap[15], tap[15:1]} as a "manual >> 1 with sign" produces
//      an unsigned 16-bit result; assigning it to `wire signed`
//      zero-extends, so center_half ends up *positive* for negative
//      taps (e.g. -1 → +65535).
//
// Cast the sign-extended concat with $signed for (1); use a real
// arithmetic shift for (2). For the pipelined partials, pre-pad each
// prod[k] to B_ACC bits via a `wire signed` so the partial-sum
// expression stays signed without an inline concat.
wire signed [B_ACC-1:0] pad_prod [0:15];
genvar pp;
generate
    for (pp = 0; pp < 16; pp = pp + 1) begin : GEN_PAD_PROD
        assign pad_prod[pp] =
            {{(B_ACC-(B_IN+19)){prod[pp][B_IN+18]}}, prod[pp]};
    end
endgenerate

// Stage 2a: four 4-way partial sums + carry center_tap alongside so the
// final acc sees the same sr[31] the original single-cycle code did.
reg signed [B_ACC-1:0] psum [0:3];
reg signed [B_IN-1:0]  center_tap_q;
reg                    pipe2a_valid;

always @(posedge clk) begin
    if (!resetn) begin
        pipe2a_valid <= 1'b0;
        center_tap_q <= {B_IN{1'b0}};
        for (i = 0; i < 4; i = i + 1) psum[i] <= {B_ACC{1'b0}};
    end else begin
        pipe2a_valid <= pipe1_valid;
        if (pipe1_valid) begin
            center_tap_q <= sr[31];
            psum[0] <= pad_prod[ 0] + pad_prod[ 1] + pad_prod[ 2] + pad_prod[ 3];
            psum[1] <= pad_prod[ 4] + pad_prod[ 5] + pad_prod[ 6] + pad_prod[ 7];
            psum[2] <= pad_prod[ 8] + pad_prod[ 9] + pad_prod[10] + pad_prod[11];
            psum[3] <= pad_prod[12] + pad_prod[13] + pad_prod[14] + pad_prod[15];
        end
    end
end

// Stage 2b: 4 partial sums + center -> acc.
reg signed [B_ACC-1:0] acc;
reg                    pipe2_valid;

wire signed [B_IN:0]   center_half_q = center_tap_q >>> 1;

always @(posedge clk) begin
    if (!resetn) begin
        acc <= {B_ACC{1'b0}}; pipe2_valid <= 1'b0;
    end else begin
        pipe2_valid <= pipe2a_valid;
        if (pipe2a_valid) begin
            acc <= $signed({{(B_ACC-B_IN-1){center_half_q[B_IN]}}, center_half_q}) +
                   psum[0] + psum[1] + psum[2] + psum[3];
        end
    end
end

// Output rounding: B_ACC -> B_OUT (truncate with round-to-nearest).
// Bit-slicing in Verilog returns *unsigned*, so rounded[B_ACC-1:SHIFT]
// must be re-signed before comparison — otherwise small positive values
// hit the negative-saturation branch (a slice of 0 looks "less than"
// signed(0x8000) under the implicit unsigned promotion) and the FIR
// pins to -32768 on quiet input.
localparam SHIFT = 16;  // Q16 coefficient scale
wire signed [B_ACC-1:0]       rounded = acc + {{(B_ACC-1){1'b0}}, acc[SHIFT-1]};
wire signed [B_ACC-SHIFT-1:0] rounded_hi = rounded[B_ACC-1:SHIFT];
always @(posedge clk) begin
    if (!resetn) begin
        dout <= {B_OUT{1'b0}}; dout_valid <= 1'b0;
    end else begin
        dout_valid <= pipe2_valid;
        if (pipe2_valid)
            dout <= rounded_hi > $signed({1'b0,{(B_OUT-1){1'b1}}}) ?
                    {1'b0,{(B_OUT-1){1'b1}}} :
                    rounded_hi < $signed({1'b1,{(B_OUT-1){1'b0}}}) ?
                    {1'b1,{(B_OUT-1){1'b0}}} :
                    rounded[B_OUT+SHIFT-1:SHIFT];
    end
end

endmodule
