kushpet/ebaz4205-sdr/(commit log)

2026-01-09 Ссылка на статью.
2026-04-19 clk, dac, adc
2026-05-01 FPGA build fixes: clk_wiz, async DMA stream, AXI3 bridge, U18 PHY refclk
    [ebaz4205.xdc, sdr_top.v]
2026-05-01 Firmware: lwIP socket-API compile fixes, function-ptr cast
    [net_init.c]
2026-05-03 EBAZ4205 board-file PCW: MT41K128M16 DDR, UART1 console, EMIO GEM0
2026-05-03 Use FreeRTOS-port XScuGic instead of our own (fixes queue.c assert)
    [net_init.c]
2026-05-03 Firmware boots: explicit lwip_init, skip lwip_sock_init busy-wait, PHY addr 0
    [main.c, net_init.c]
2026-05-03 ddc_top: assert m_axis_tlast every N samples to clear DMA timeout
2026-05-03 ip101g: derive speed from ANAR ∩ ANLPAR, don't restart auto-neg
2026-05-06 sdra_tcp_server: skeleton listener with RTL0 greeting + zero-IQ pump
2026-05-06 sdra_tcp_server: ship DDC DMA buffers instead of zero-pump
2026-05-09 tools: add test_tcp_rx.py — connects, parses SDRA header, reports I/Q stats; --freq/--rate to drive in-band commands
2026-05-09 hb_fir_decimator: fix unsigned-mix in acc summation (was pinning dout to ±32767)
    [hb_fir_decimator.v, tb_cic_zero.v, tb_ddc_full.v, tb_hb_fir.v]
2026-05-11 nco_direct: precompute sincos LUT — Vivado synth dropped $sin/$cos in initial, leaving the LUT with no driver and the entire DDC/DUC chain multiplying by zero
2026-05-11 hb_fir_decimator: pipeline 16-product adder tree — was 14-DSP chain, drove WNS to −12.6 ns and wedged the 60 MHz domain
2026-05-11 adc_if: invert MSB before sign-extend — AD9226 LQFP-48 module outputs straight binary, not twos complement
    [adc_if.v]
2026-05-11 ddc_top, sdra_tcp_server: expose ADC min/max in status reg and decode in [dbg] print — coarse signal-amplitude readout without ILA
2026-05-11 duc_top, ddc_ctrl: DAC test mode (NCO cosine direct to DAC) for ADC loopback debug; off at boot to avoid in-band EMI during antenna RX
    [duc_top.v, main.c]
2026-05-11 sd_boot: rebuild BOOT.bin with current bitstream and firmware
2026-05-11 ddc_top, ddc_ctrl, sdra_tcp_server: clear sticky min/max/ovf via status-reg write; auto-clear after [dbg] print so the envelope tracks the last ~6.5 s window
2026-06-01 cic_decimator: R-aware output slice — static [B_INT-1:B_INT-B_OUT] threw away ~11 bits of magnitude at R=30 (≈ 60 dB of dead-loss attenuation); pick the slice based on decimation_r and saturate to in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
2026-06-01 README: short overview + build/run instructions + assembly photo
